RicardoStephen/Actuator_Board/media/actuator_schematic_channel.jpg

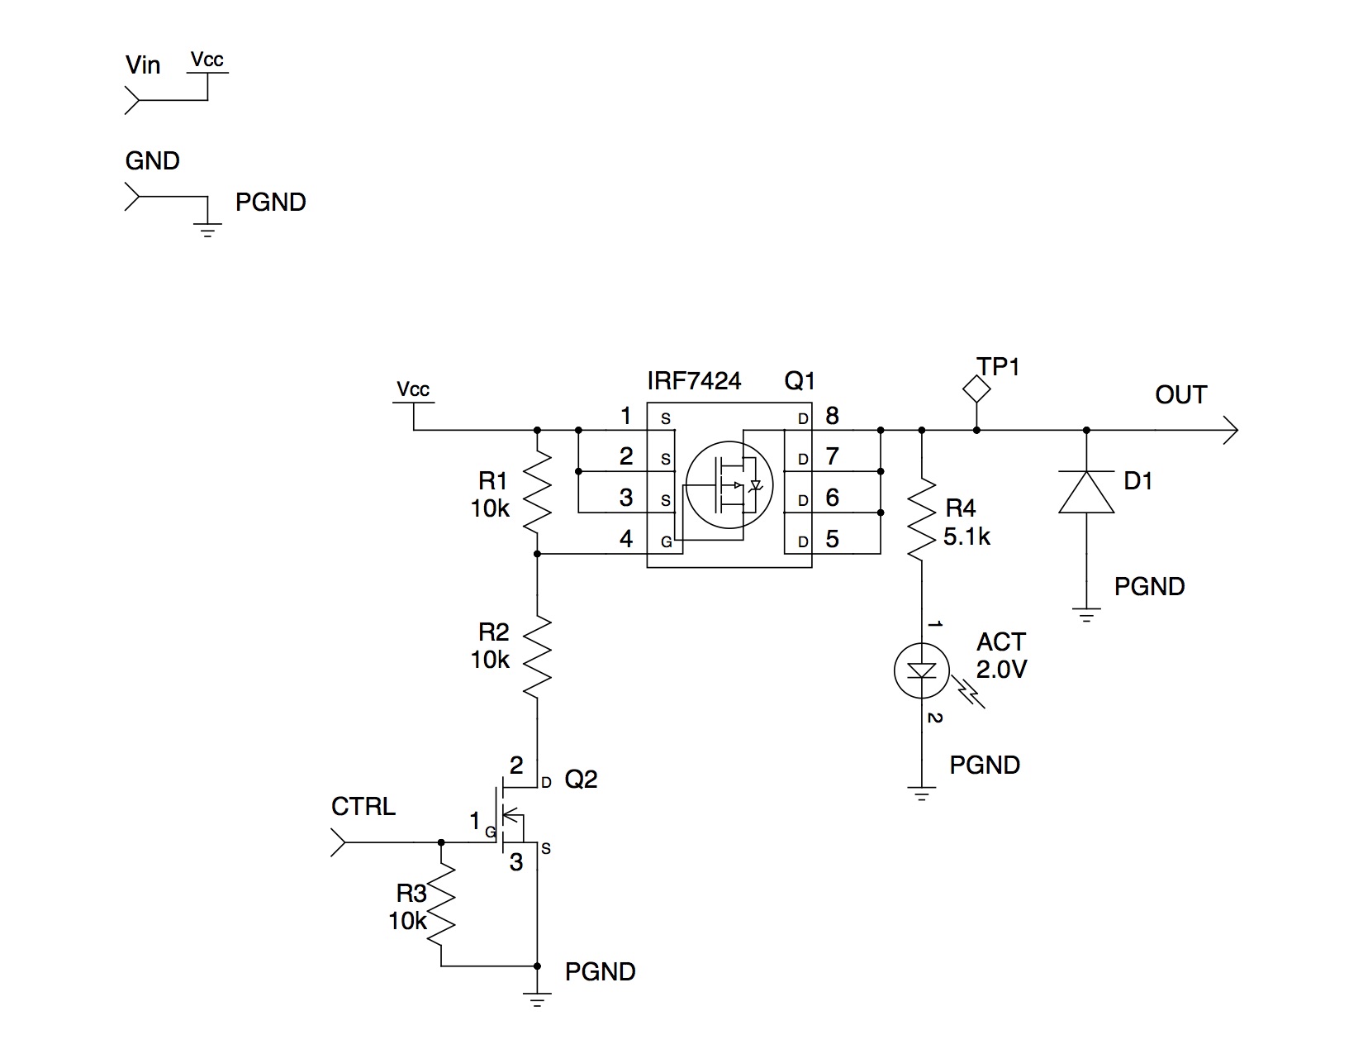
media/actuator_schematic_channel.jpg
