RicardoStephen/Actuator_Board/(list of files, drawings)

Other design files:
actuator.pcb
