RicardoStephen/Actuator_Board/(commit log)

2016-08-29 moved to github, testing md pdf image
    [actuator.pcb, actuator.sch, channel.sch]
2016-08-29 replaced pdfs with jpgs
    [actuator.pcb, actuator.sch, channel.sch]
2016-08-29 updated README caption alignment, cropped full schematic
2016-08-29 removed full schematic -- github won't update
2016-08-29 readded full schematic
